eSpark-Backup/michaelquartey-sonography-hw/Design_Files/Renderings/3D_Top_View.PNG

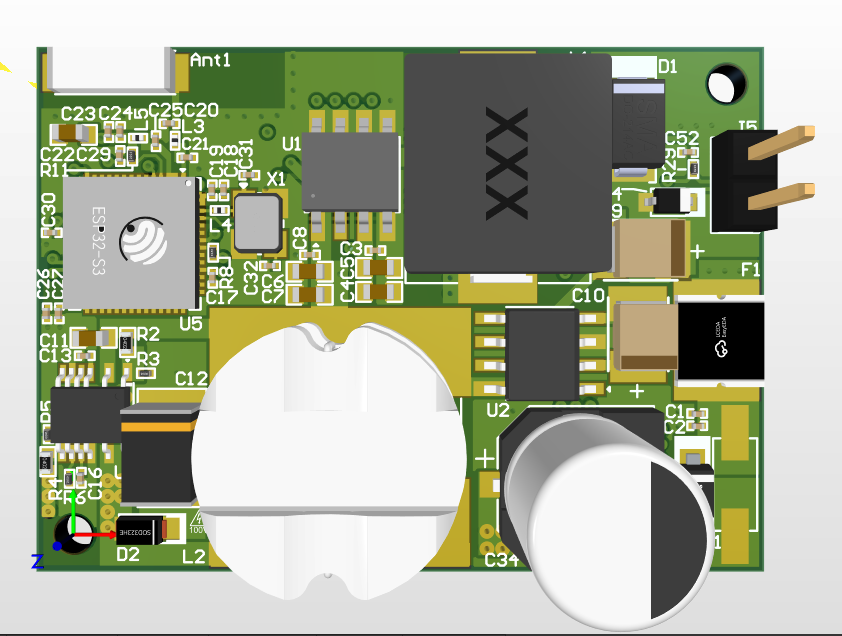
Design_Files/Renderings/3D_Top_View.PNG
