eSpark-Backup/michaelquartey-sonography-hw/Design_Files/Renderings/2D_BottomLayer.PNG

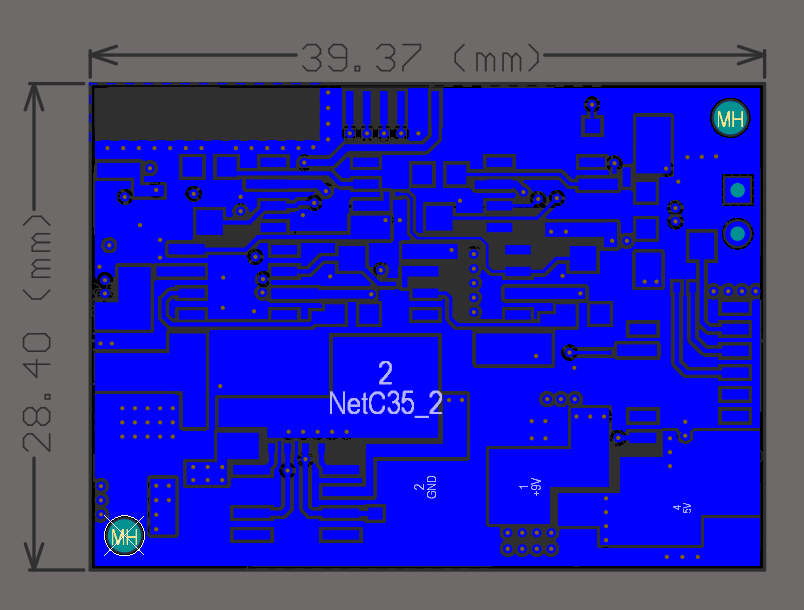
Design_Files/Renderings/2D_BottomLayer.PNG
