eSpark-Backup/michaelquartey-sonography-hw/Design_Files/Renderings/2D_C_View.PNG

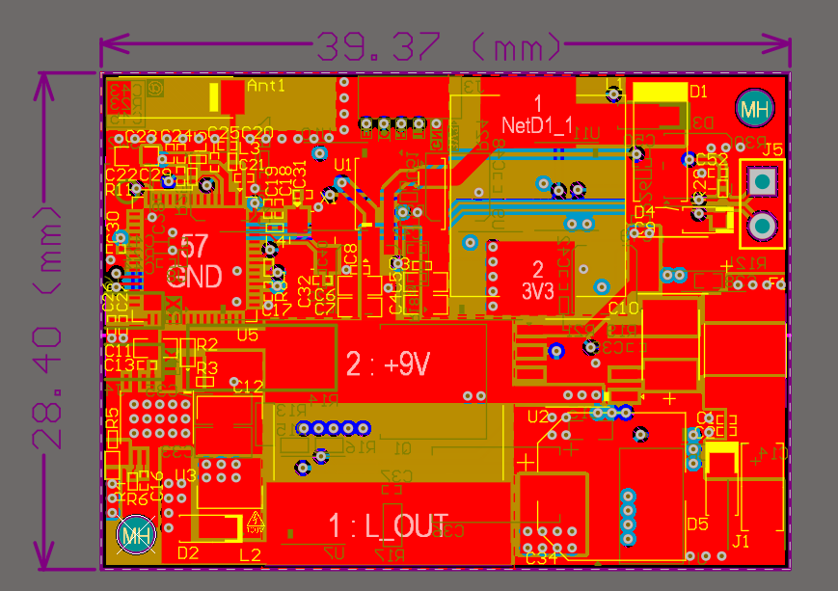
Design_Files/Renderings/2D_C_View.PNG
