eSpark-Backup/michaelquartey-sonography-hw/Design_Files/Renderings/2D_GND_Layer.PNG

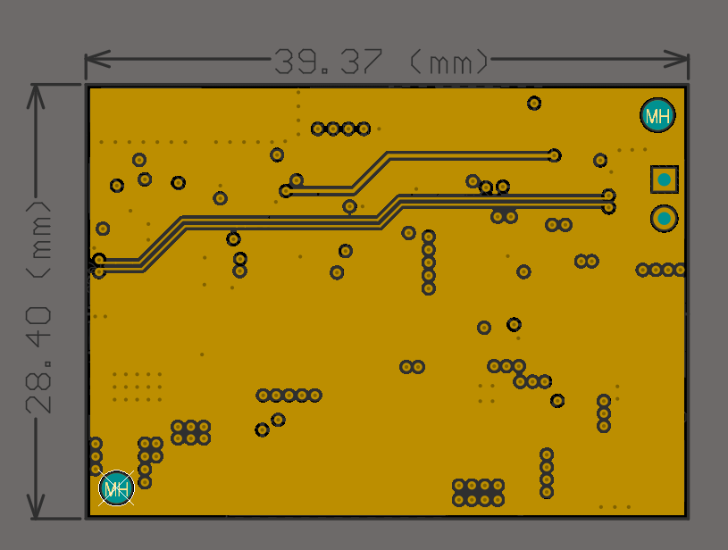
Design_Files/Renderings/2D_GND_Layer.PNG
