eSpark-Backup/michaelquartey-sonography-hw/Design_Files/Renderings/2D_PWR_Layer.PNG

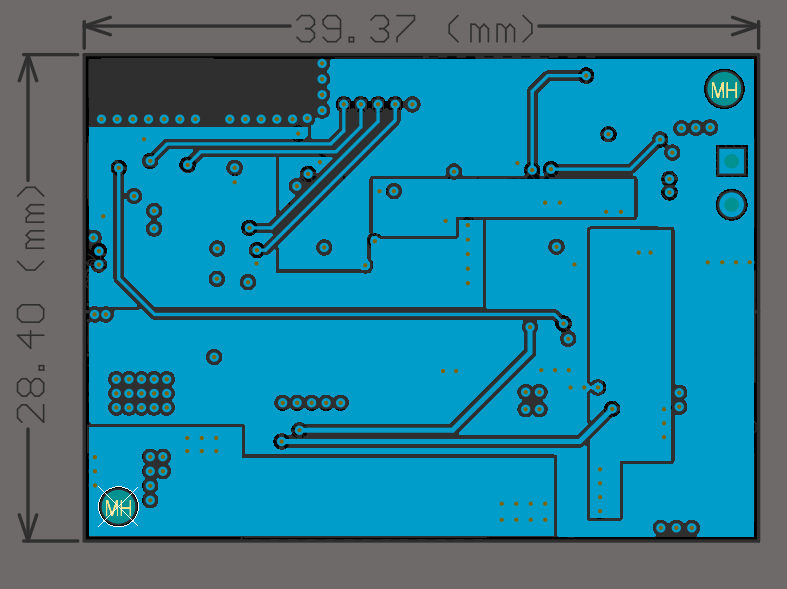
Design_Files/Renderings/2D_PWR_Layer.PNG
