eSpark-Backup/michaelquartey-sonography-hw/Design_Files/Renderings/2D_TopLayer.PNG

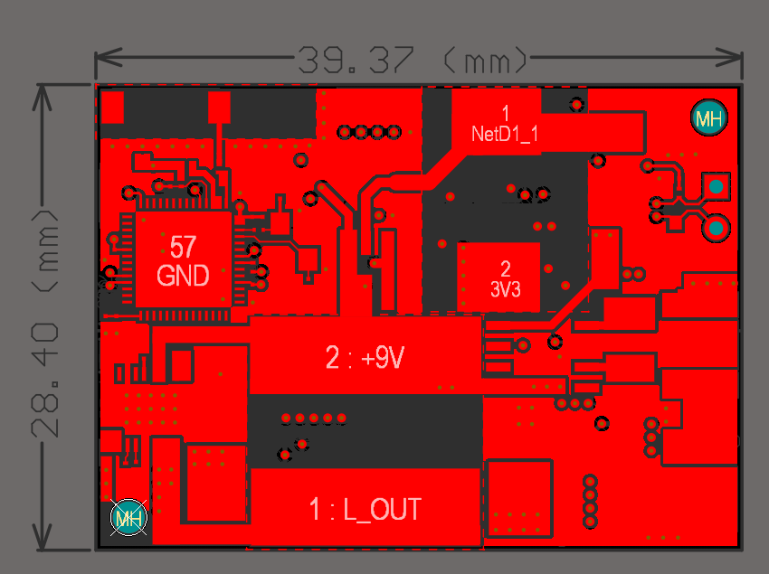
Design_Files/Renderings/2D_TopLayer.PNG
