eSpark-Backup/michaelquartey-sonography-hw/Design_Files/BOM/Clinet_BOM-Sonography-v1.0.xlsx

# | Item Type | Designator | Description | Footprint | Manufacturer Part Number | Manufacturer | Comment | Quantity | Remarks
1 | Antenna | ANT1 | SMD Antennas ROHS | AN6520-245 | AN6520-245 | Rainsun microwave Tech | AN6520-245 | 1
2 | Capacitor | C1, C13, C18, C23, C27, C29 | CAP CER 1UF 16V X5R 0201 | CAP-0201 | GRM033R61C105ME15D | Murata | 1uF | 6
3 | Capacitor | C2, C3, C8, C16, C17, C19, C24, C25, C26, C28, C30, C37, C40, C41, C42, C43, C46, C47, C48, C49 | CAP CER 0.1UF 25V X5R 0201 | CAP-0201 | GRM033R61E104KE14D | Murata | 0.1uF | 20
4 | Capacitor | C4, C5, C6, C7, C11, C15, C22 | 10uF 35V X5R 20% Pad SMD 0603 | Cap-0603 | GRM188R6YA106MA73D | Murata | 10uF | 7
5 | Capacitor | C9, C10, C14 | 10uF 25V 2.5Ω@100kHz ±10% CASE-B-3528 Tantalum Capacitors ROHS | Case-B | CA45-B025K106T | Xiangyee in S&T | 10uF | 3
6 | Capacitor | C12 | 250V 1uF X7R ±10% 1812 Multilayer Ceramic Capacitors MLCC - SMD/SMT ROHS | Cap-1812 | FS43X105K251EGG | PSA | 1uF | 1
7 | Capacitor | C20 | CAP CER 2.7PF 50V C0G/NPO 0201 | CAP-0201 | CC0201CRNPO9BN2R7 | Yageo | 2.7pF | 1
8 | Capacitor | C21 | CAP CER 4.7PF 50V C0G/NPO 0201 | CAP-0201 | CC0201BRNPO9BN4R7 | Yageo | 4.7pF | 1
9 | Capacitor | C31, C32 | CAP CER 22PF 50V C0G/NP0 0201 | CAP-0201 | GRM0335C1H220JA01D | Murata | 22pF | 2
10 | Capacitor | C33, C35 | 200V 100nF X7R ±10% 0805 Multilayer Ceramic Capacitors MLCC - SMD/SMT ROHS | Cap-0805 | FM21X104K201ECG | PSA | 100nF | 2
11 | Electrolytic Capacitor | C34 | 22uF 200V 320mA@100kHz ±20% SMD,D8xL16.5mm Aluminum Electrolytic Capacitors - SMD ROHS | VKMD1652D220MV | VKMD1652D220MV | Ymin | 22uF | 1
12 | Capacitor | C36 | 47uF 25V 0.9Ω@100kHz ±10% CASE-D-7343 Tantalum Capacitors ROHS | Case-D | CA45-D025K476T | Hunan Xiangyee in S&T | 47uF | 1
13 | Capacitor | C38 | 50V 50pF C0G ±5% 0402 Multilayer Ceramic Capacitors MLCC - SMD/SMT ROHS | Cap-0402 | 0402CG500J500NT | FH | 50pF | 1
14 | Capacitor | C39, C44, C45, C50, C51, C52 | 50V 1nF X7R ±10% 0201 Multilayer Ceramic Capacitors MLCC - SMD/SMT ROHS | CAP-0201 | 0201B102K500NT | FH | 1nF | 6
15 | Diode | D1 | 40V 3A 550mV@3A SMA(DO-214AC) Schottky Barrier Diodes (SBD) ROHS | SMA(DO-214AC) | B340A | FUXINSEMI | B340A | 1
16 | Schottky Barrier Diodes | D2 | Diode Schottky 150V 500mA 2-Pin SOD-323HE Emboss T/R | SOD-323HE | RB558VAM150TR | Rohm | RB558VAM150TR | 1
17 | Diode | D3 | 100V 400mW Single 1.25V@150mA 8ns 300mA SOD-123 Switching Diode ROHS | SOD-123 | 1N4148W | JSMSEMI | 1N4148W | 1
18 | Diode | D4 | ±5% Single 3.1V~3.5V 300mW 3.3V SOD-323 Zener Diodes ROHS | SOD-323 | MM3Z3V3 | JSMSEMI | MM3Z3V3 | 1
19 | Diode | D5 | 10.1A 200W 19.9V 13.3V 12V SOD-123F Electrostatic and Surge Protection (TVS/ESD) ROHS | SOD-123F | SMF12A | Shandong Jingdao Microelectronics | SMF12A | 1
20 | Fuse | F1 | 10V 2A 100A 4A 2018 Resettable Fuses ROHS | SMD2018-200 | SMD2018-200 | Tech Fuse | SMD2018-200 | 1
21 | Connector | J1 | Gold 250V 3A Brick nogging Square Pins 2.5mm 2P 260℃ 6mm -40℃~+105℃ 2.54mm 双排 Black Brass 2x1P SMD,P=2.54mm Pin Headers ROHS | X6521WVS-2x01H-C60D74 | X6521WVS-2x01H-C60D74 | XKB Connectivity | X6521WVS-2x01H-C60D74 | 1
22 |  | J3 | 1x6P | 1x6p |  |  | 1x6P | 1
23 | SMD Pad | J4, J6 | Wire Connecting Pad | 1P SMD PAD | 1P SMD PAD |  | 1P SMD PAD | 2
24 | Male Header | J5 | CONN HEADER VERT 2POS 2.54MM | HDR1X2_ | 8266292 | TE Connectivity | 826629-2 | 1
25 | Inductor | L1 | 3A 47uH Molding Choke ±20% 4.5A SMD Power Inductors ROHS | SMMS1050-470M | SMMS1050-470M | SXN | 47uH | 1
26 | Inductor | L2 | Ind Power Unshielded Wirewound 100uH 10% 100KHz 25Q-Factor Ferrite 1.9A T/R | SDR1307A-101K | SDR1307A-101K | Bourns | 100uH | 1
27 | Inductor | L3 | FIXED IND 1.6NH 1A 50 MOHM SMD | IND-0201 | LQP03HQ1N6B02D | Murata | 1.6nH | 1
28 | Inductor | L4 | 140mA 24nH ±3% 2.3Ω 0201 Inductors (SMD) ROHS | IND-0201 | LQP03TN24NH02D | Murata | 24nH | 1
29 | Inductor | L5 | FIXED IND 2NH 600MA 100 MOHM SMD | IND-0201 | MLG0603P2N0CT000 | TDK | 2nH | 1
30 | Mosfet | Q1 | 200V 5A 78W 580mΩ@10V,2.5A 3V@250uA N Channel TO-252-2(DPAK) MOSFETs ROHS | DPAK | 5N20A-252 | GOFRD | 5N20A-252 | 1
31 | Resistor | R2, R4 | 125mW ±100ppm/℃ ±0.5% 1MΩ 0402 Chip Resistor - Surface Mount ROHS | Res-0402 | WF04H1004DTL |  | 1M | 2
32 | Resistor | R3 | SMD Chip Resistor, 287 kOhm, ± 1%, 50 mW, 0201 [0603 Metric], Thick Film, General Purpose | Res-0201 | RC0201FR-07287KL | YAGEO | 287K | 1
33 | Resistor | R5 | 50mW Thick Film Resistors 25V ±1% ±200ppm/℃ 16.2kΩ 0201 Chip Resistor - Surface Mount ROHS | Res-0201 | RTT011622FTH | RALEC | 16.2K | 1
34 | Resistor | R6 | Res Thick Film 0201 154K Ohm 1% 1/20W ±200ppm/°C Molded SMD Paper T/R | Res-0201 | RC0201FR-07154KL | YAGEO | 154K | 1
35 | Resistor | R8 | RES 499 OHM 1% 1/20W 0201 | Res-0201 | RC0201FR-07499RL | Yageo | 499R | 1
36 | Resistor | R11 | RES SMD 10K OHM 1% 1/20W 0201 | Res-0201 | RC0201FR-0710KL | Yageo | 10K | 1
37 | Potentiometer | R12, R18, R19, R25, R30 | TRIMMER 10K OHM 0.1W J LEAD TOP | TC33X-2-103E_ | TC33X-2-103E | Bourns | 10K | 5
38 | Resistor | R13 | RES SMD 3K OHM 1% 1/3W 0603 | Res-0603 | CRCW06033K00FKEAHP | Vishay Intertech | 3K | 1
39 | Resistor | R14 | 1W Thick Film Resistors 200V ±100ppm/℃ ±5% 51Ω 2512 Chip Resistor - Surface Mount ROHS | RES-2512 | RC2512JK-0751RL | YAGEO | 51R | 1
40 | Resistor | R15, R16 | RESISTOR 0402 JUMPER ZERO OHM | Res-0402 | AC0402FR-070RL | Yageo | 0R | 2
41 | Resistor | R17 | RES SMD 10K OHM 5% 1/4W 0603 | Res-0603 | ESR03EZPJ103 | ROHM Semicon | 10K | 1
42 | Resistor | R20 | 50mW Thick Film Resistors ±5% ±200ppm/℃ 68Ω 0201 Chip Resistor - Surface Mount ROHS | Res-0201 | 0201WMJ0680TEE | UNI-ROYAL | 68R | 1
43 | Resistor | R21 | 50mW Thick Film Resistors ±200ppm/℃ ±5% 820Ω 0201 Chip Resistor - Surface Mount ROHS | Res-0201 | WR02X821JAL | Walsin Tech Corp | 820R | 1
44 | Resistor | R22, R26 | 50mW ±1% ±200ppm/℃ 330Ω 0201 Chip Resistor - Surface Mount ROHS | Res-0201 | RC-01W3300FT | FH | 330R | 2
45 | Resistor | R23 | 50mW ±5% ±200ppm/℃ 470Ω 0201 Chip Resistor - Surface Mount ROHS | Res-0201 | RC-01W471JT | FH | 470R | 1
46 | Potentiometer | R24 | TRIMMER 100K OHM 0.1W J LEAD TOP | TC33X-2-104E_ | TC33X-2-104E | Bourns | 100K | 1
47 | Resistor | R27 | 50mW Thick Film Resistors ±5% ±200ppm/℃ 1.5kΩ 0201 Chip Resistor - Surface Mount ROHS | Res-0201 | RTT01152JTH | RALEC | 1.5K | 1
48 | Resistor | R28 | RES 1K OHM 1% 1/20W 0201 | Res-0201 | RC0201FR-071KL | Yageo | 1K | 1
49 | Resistor | R29 | 50mW ±1% 100Ω 0201 Chip Resistor - Surface Mount ROHS | Res-0201 | CR0201FH1000G | LIZ ELEC | 100R | 1
50 | Switch | SW2 | SWITCH TACTILE SPST-NO 0.05A 12V | B3U-1000P | B3U-1000P | Omron | B3U-1000P | 1
51 | Regulator | U1 | IC REG BUCK 3.3V 2A 8SOIC | SOP-8L | AP1509-33SG-13 | Diodes | AP1509-33SG-13 | 1
52 | IC | U2 | Charge Pump INV/STPUP/STPDN -1.5V to -10V 100mA 8-Pin SOIC T/R / IC REG SWITCHD CAP INV 8SOIC | SOIC-8(0.154", 3.90mm Width) | TL7660CDR | Texas Instruments | TL7660CDR | 1
53 | IC | U3 | IC REG MULTI CONFG ADJ 16MSOP | 16-MSOP-EP | LT8331IMSE#TRPBF | Analog Devices | LT8331IMSE#TRPBF | 1
54 | IC | U4 | SOT-223 Linear Voltage Regulators (LDO) ROHS | SOT- 223 | AMS1117-5.0 | HX(hengjiaxing) | AMS1117-5.0 | 1
55 | IC | U5 | 21dBm ESP32-S3R8 2.4GHz SMD WiFi Modules ROHS | QFNWB-56 (7×7) | ESP32-S3FH4R2 | Espressif Systems | ESP32-S3FH4R2 | 1
56 | IC | U6 | 45ns 4.75V~5.25V SOIC-14 Monostable Multivibrators ROHS | SOIC-14 | SN74121D | Taxes Instrument | SN74121D | 1
57 | IC | U7 | MOSFET 4.5V~15V SOIC-8 Gate Drive ICs ROHS | SOIC-8(0.150", 3.80mm Width) | ICL7667CBAZA | RENESAS | ICL7667CBAZA | 1
58 | IC | U8, U9, U10 | Video Amplifier, 1, 140 Mhz, 2500 V/ S, 0 C, 70 C, 100 Ma Rohs Compliant: Yes | SOIC-8(0.154", 3.90mm Width) | AD811JRZ | Analog Devices | AD811JRZ | 3
59 | IC | U11 | Very High Speed, High Output Current, Voltage Feedback Amplifier 8-SOIC -40 to 85 | SOIC-8(0.154", 3.90mm Width) | LM7171AIMX/NOPB | TI National Semiconductor | LM7171AIMX/NOPB | 1
60 | Crystal | X1 | 40MHz SMD Crystal Resonator 15pF SMD3225-4P Crystals ROHS | X322540MPB4SI_ | X322540MPB4SI | Yangxing Tech | 40MHz | 1
