eSpark-Backup/michaelquartey-sonography-hw/Design_Files/Supporting_Files/PCB_Sonography-v1.0.DXF

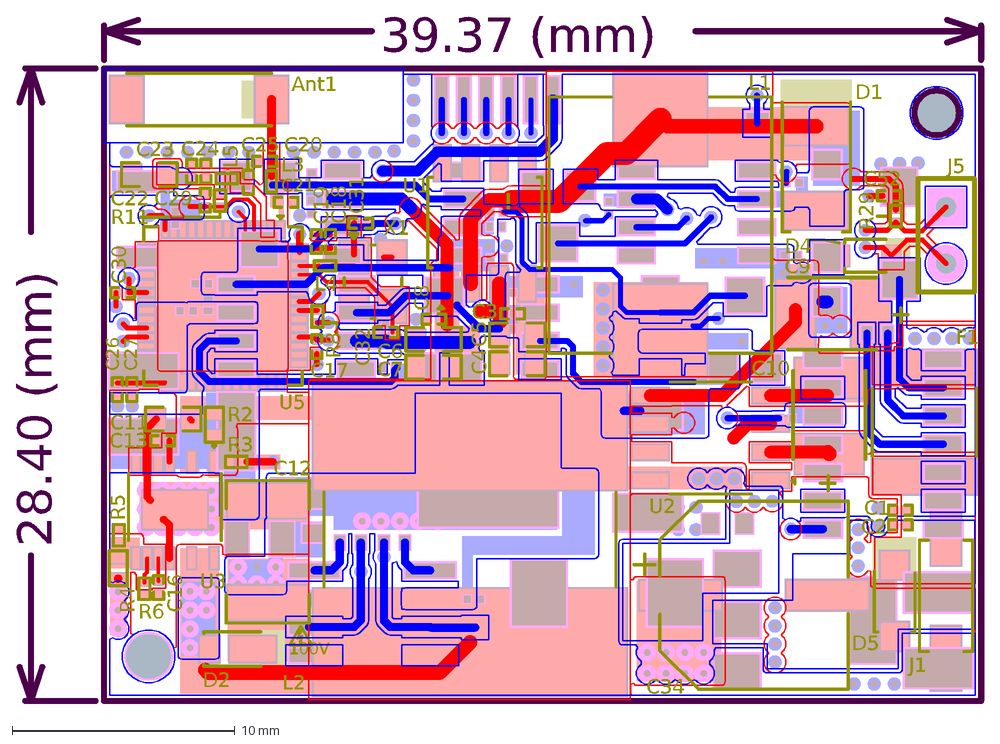
[picture p9: CAD file, 2024-06-08]
Design_Files/Supporting_Files/PCB_Sonography-v1.0.DXF
100V
28.40 (mm)
39.37 (mm)
Ant1
U5
D5
R5
C10
C9
L3
D4
D2
U3
C34
F1
J1
J5
X1
R11
R8
L5
L4
C27
C25
C24
C23
C22
C13
C8
C3
U1
U2
R29
R6
R4
R3
R2
L2
L1
D1
C52
C32
C31
C30
C29
C26
C21
C20
C19
C18
C17
C16
C12
C11
C7
C6
C5
C4
C2
C1
