eSpark-Backup/michaelquartey-sonography-hw/(list of files, cad)

Other CAD files:
Design_Files/Supporting_Files/PCB_Sonography-v1.0.DWG
