eSpark-Backup/michaelquartey-sonography-hw/Design_Files/Schematics/Schematics_Sonography-v1.0.pdf

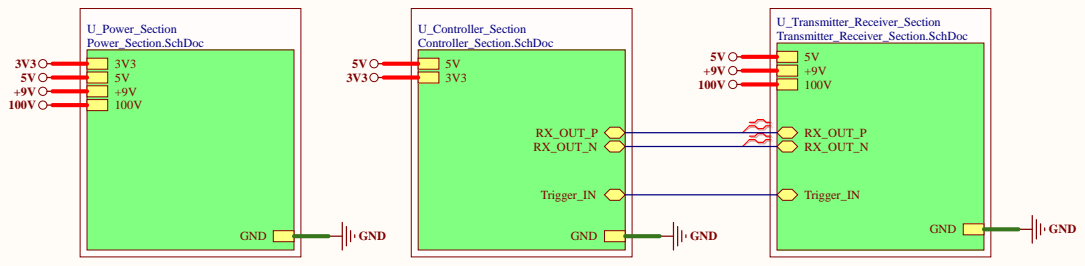
[picture p10: page 1]

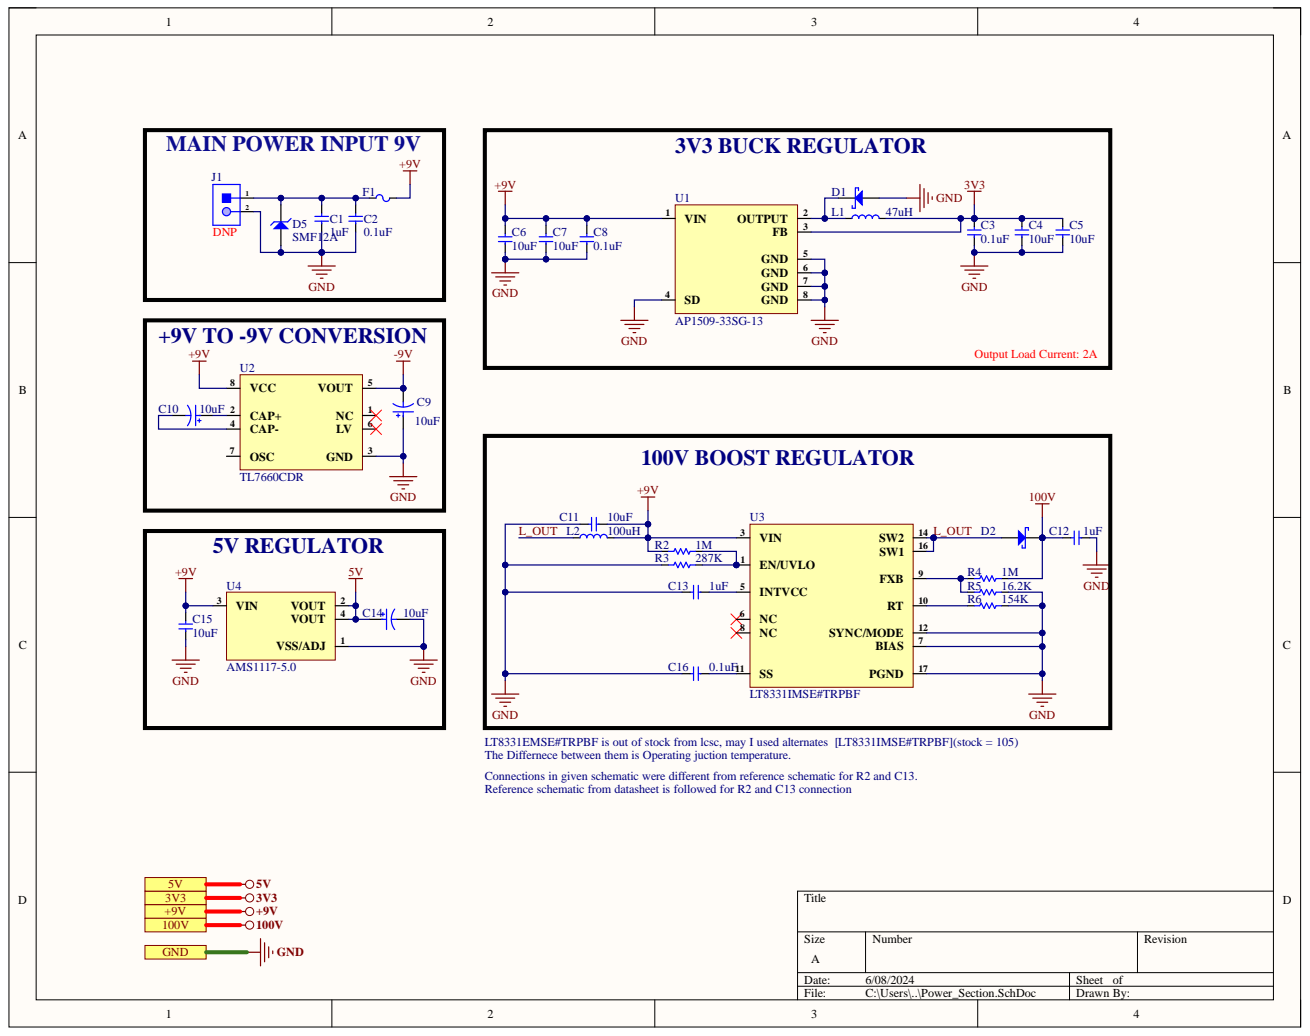
[picture p11: page 2]

LT8331EMSE#TRPBF is out of stock from lcsc, may I used alternates [LT8331IMSE#TRPBF](stock = 105)
The Differnece between them is Operating juction temperature.
Connections in given schematic were different from reference schematic for R2 and C13.
Reference schematic from datasheet is followed for R2 and C13 connection

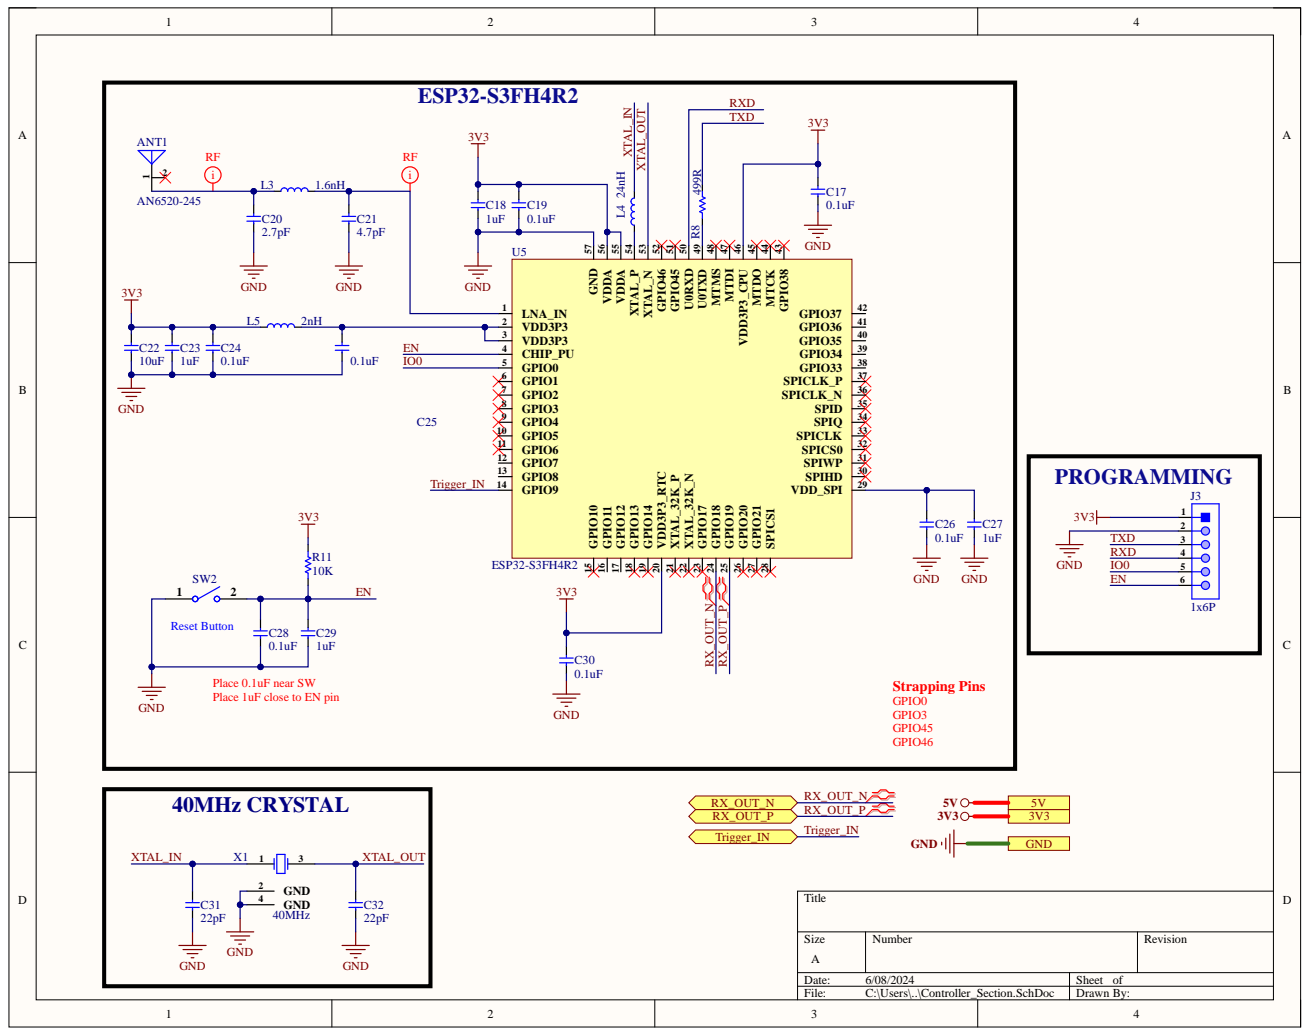
[picture p12: page 3]

Place 0.1uF near SW
Place 1uF close to EN pin

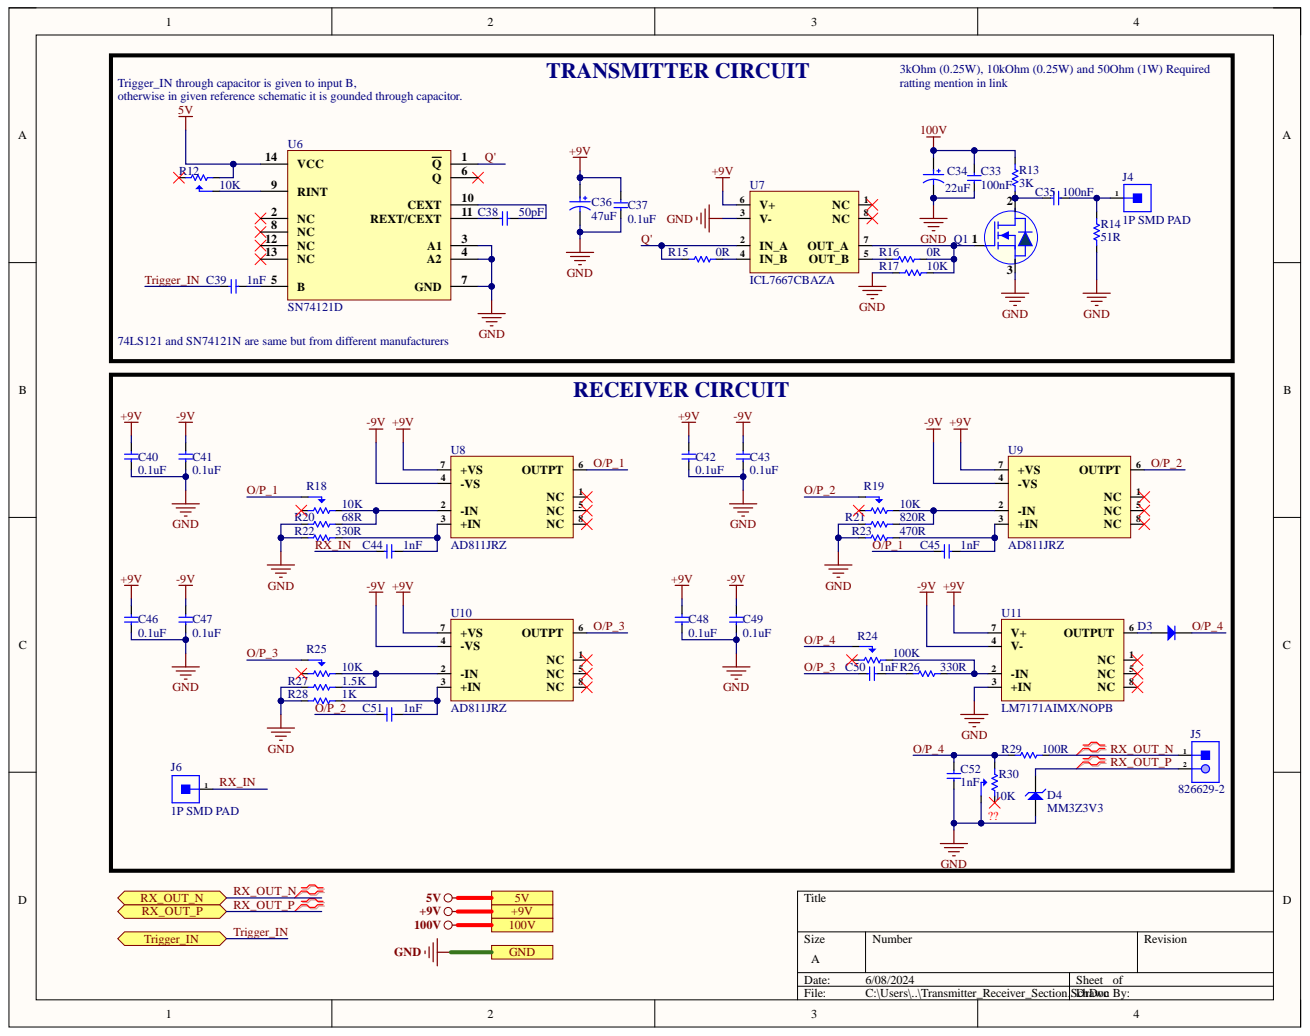
[picture p13: page 4]

3kOhm (0.25W), 10kOhm (0.25W) and 50Ohm (1W) Required
ratting mention in link

Trigger_IN through capacitor is given to input B,
otherwise in given reference schematic it is gounded through capacitor.

74LS121 and SN74121N are same but from different manufacturers
