eSpark-Backup/michaelquartey-sonography-hw/Design_Files/Schematics/Assembly_Drawings-v1.0.pdf

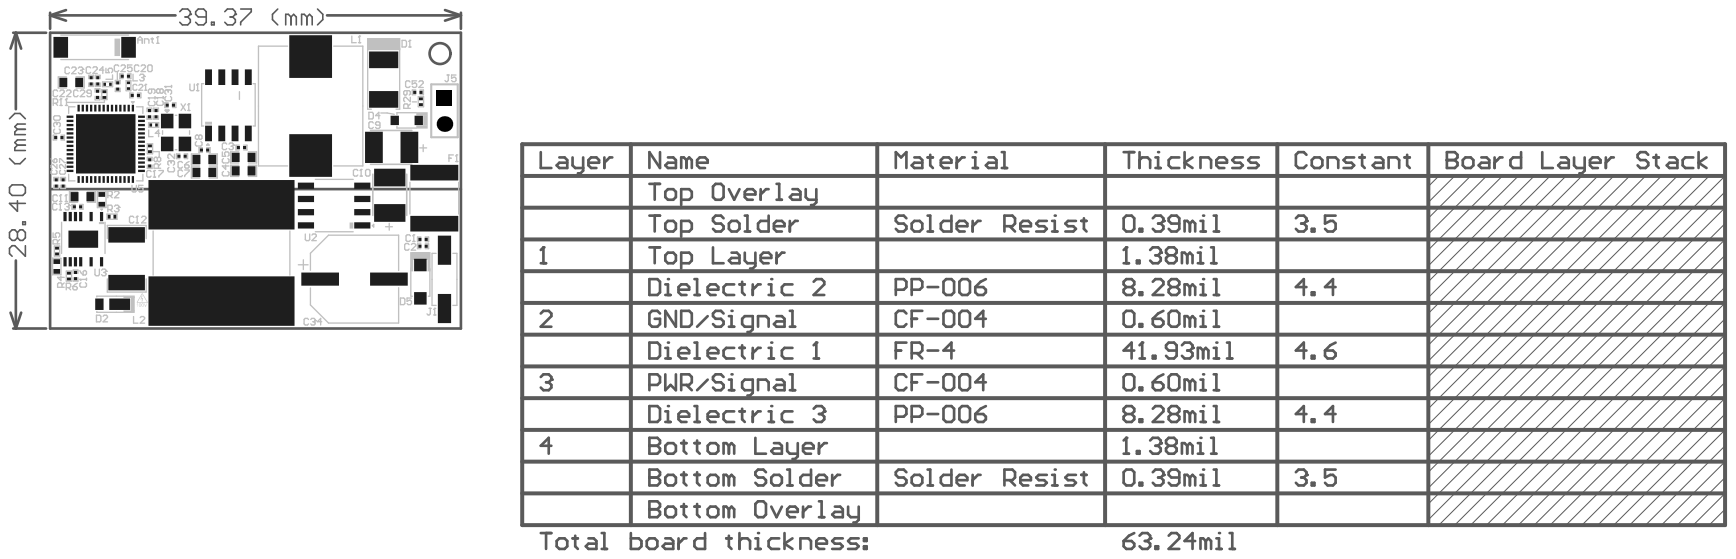
[picture p14: page 1]

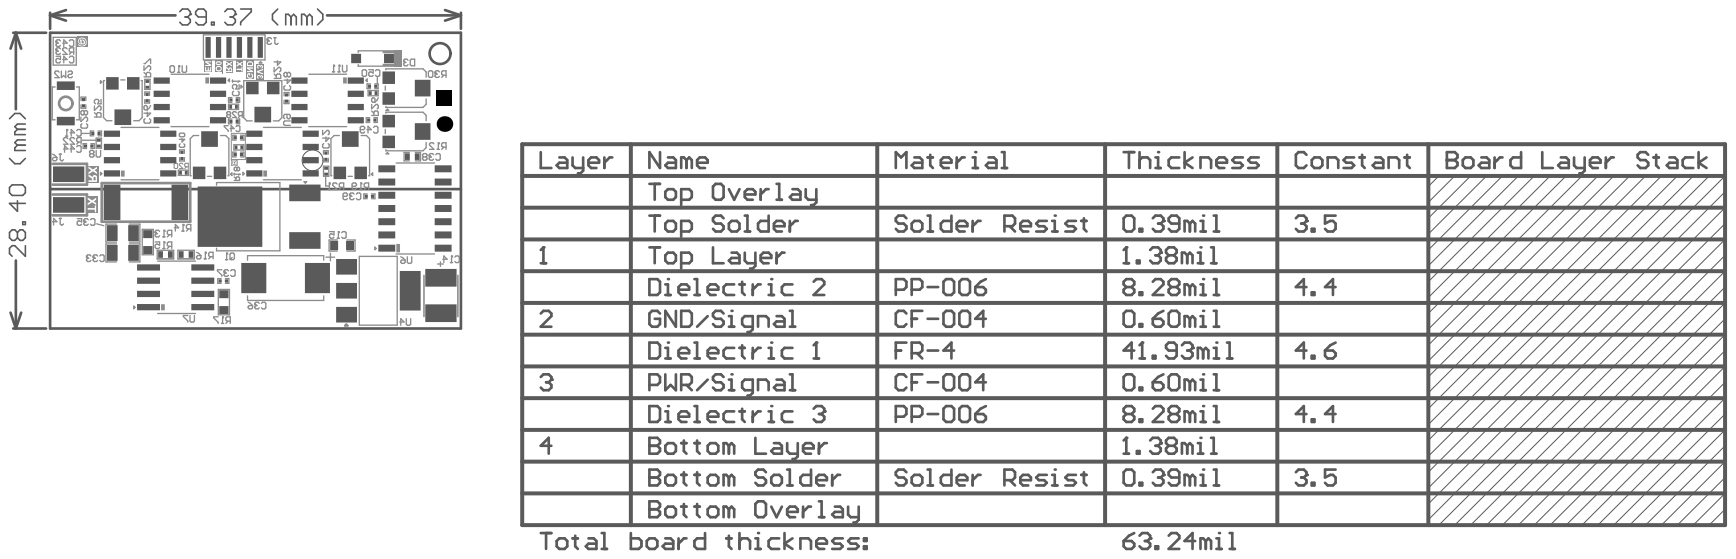
[picture p15: page 2]
