eSpark-Backup/michaelquartey-sonography-hw/(list of files, drawings)

Other design files:
Design_Files/Controller_Section.SchDoc
Design_Files/PCB_Sonography-v1.0.PcbDoc
Design_Files/Power_Section.SchDoc
Design_Files/Sonography-v1.0.PrjPcb
Design_Files/Top_sheet.SchDoc
Design_Files/Transmitter_Receiver_Section.SchDoc
