eSpark-Backup/michaelquartey-sonography-hw/(commit log)

2023-11-24 Receiver circuitry added
    [Receiver_Section.SchDoc, Sonography_Project.PrjPcb]
2023-11-27 #2 Schematic in Progress
    [Controller_Section.SchDoc, Power_Section.SchDoc, Receiver_Section.SchDoc, Sonography_Project.PrjPcb]
2023-11-29 #2 In progress
    [Controller_Section.SchDoc, Power_Section.SchDoc, Receiver_Section.SchDoc, Sonography_Project.PrjPcb, Transmitter_Section.SchDoc]
2023-12-04 Top sheet in Progress
    [Controller_Section.SchDoc, Power_Section.SchDoc, Sonography_Project.PrjPcb, Top_sheet.SchDoc, Transmitter_Receiver_Section.SchDoc]
2023-12-05 #2 Schematic completed
    [Controller_Section.SchDoc, Power_Section.SchDoc, Sonography_Project.PrjPcb, Top_sheet.SchDoc, Transmitter_Receiver_Section.SchDoc]
2023-12-05 Parts Placement in Progress
    [Controller_Section.SchDoc, Power_Section.SchDoc, Sonography_PCB.PcbDoc, Sonography_Project.PrjPcb, Transmitter_Receiver_Section.SchDoc]
2023-12-05 #3 Placement In-progress.
    [Controller_Section.SchDoc, Power_Section.SchDoc, Sonography_PCB.PcbDoc, Sonography_Project.PrjPcb, Top_sheet.SchDoc, Transmitter_Receiver_Section.SchDoc]
2023-12-06 #3 Parts Placement in progress
    [Controller_Section.SchDoc, Power_Section.SchDoc, Sonography_PCB.PcbDoc, Sonography_Project.PrjPcb, Transmitter_Receiver_Section.SchDoc]
2023-12-11 #3 Parts Placement completed
    [Power_Section.SchDoc, Sonography_PCB.PcbDoc, Sonography_Project.PrjPcb, Transmitter_Receiver_Section.SchDoc]
2023-12-12 #3 Routing in Progress
    [Controller_Section.SchDoc, Power_Section.SchDoc, Sonography_PCB.PcbDoc, Transmitter_Receiver_Section.SchDoc]
2023-12-15 #3 Routing completed
    [Sonography_PCB.PcbDoc]
2023-12-18 #3 modification in Routing
    [Power_Section.SchDoc, Sonography_PCB.PcbDoc]
2023-12-19 LT8331IMSE#TRPBF footprint updated in PCB
    [Power_Section.SchDoc, Sonography_PCB.PcbDoc, Transmitter_Receiver_Section.SchDoc]
2023-12-20 #3 PCB updated acc to library review
    [Controller_Section.SchDoc, Power_Section.SchDoc, Sonography_PCB.PcbDoc, Transmitter_Receiver_Section.SchDoc]
2023-12-20 Parameters added for BOM easiness
    [Controller_Section.SchDoc, Power_Section.SchDoc, Sonography_PCB.PcbDoc, Sonography_Project.PrjPcb, Transmitter_Receiver_Section.SchDoc]
2024-01-22 #3 Placement in Progress
    [Controller_Section.SchDoc, Power_Section.SchDoc, Sonography_PCB.PcbDoc, Transmitter_Receiver_Section.SchDoc]
2024-01-24 #3 Routing Completed, no DRC errors
    [Controller_Section.SchDoc, Power_Section.SchDoc, Sonography_PCB.PcbDoc, Transmitter_Receiver_Section.SchDoc]
2024-01-25 #5 Adjustments in routing and designators: Review In-process.
    [Controller_Section.SchDoc, PCB_Sonography-v1.0.PcbDoc, Power_Section.SchDoc, Sonography-v1.0.PrjPcb, Sonography_PCB.PcbDoc, Sonography_Project.PrjPcb, Top_sheet.SchDoc, Transmitter_Receiver_Section.SchDoc]
2024-01-26 #3 Changes done acc: to #4 and Client BOM generated But peripherals need to be added
    [Client_BOM.xlsx, Controller_Section.SchDoc, PCB_Sonography-v1.0.PcbDoc, Power_Section.SchDoc, Sonography-v1.0.PrjPcb]
2024-01-26 #5 Fresh Deliverables generated: Peripherals need to add in Client BOM
    [Centroid_File-Sonography-v1.0.csv, Controller_Section.SchDoc, PCB_Sonography-v1.0.DWG, PCB_Sonography-v1.0.DXF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]
2024-01-29 #5 Fresh Deliverables after modifications in Routing: Peripherals needs to be entered in BOM.
    [Centroid_File-PCB_Sonography-v1.0.csv, Centroid_File-Sonography-v1.0.csv, Client_BOM.xlsx, PCB_Sonography-v1.0.DWG, PCB_Sonography-v1.0.DXF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]
2024-04-01 added .gitignore
    [PCB_Sonography-v1.0.GBL, PCB_Sonography-v1.0.GBO, PCB_Sonography-v1.0.GBP, PCB_Sonography-v1.0.GBS, PCB_Sonography-v1.0.GTL, PCB_Sonography-v1.0.GTO, PCB_Sonography-v1.0.GTP, PCB_Sonography-v1.0.GTS]
2024-05-21 #2 PCB updated acc to required change in sch
    [Controller_Section.SchDoc, PCB_Sonography-v1.0.PcbDoc, Sonography-v1.0.PrjPcb]
2024-05-24 #2 LCD and its circuitry removed
    [Controller_Section.SchDoc, PCB_Sonography-v1.0.PcbDoc]
2024-05-31 #3 Placement completed
    [PCB_Sonography-v1.0.PcbDoc]
2024-06-06 PCB completed, step file added, programing connector added in controller sheet
    [Controller_Section.SchDoc, PCB_Sonography-v1.0.PcbDoc]
2024-06-07 #5 In-progress.
    [Controller_Section.SchDoc, PCB_Sonography-v1.0.PcbDoc, Power_Section.SchDoc, Sonography-v1.0.PrjPcb, Transmitter_Receiver_Section.SchDoc]
2024-06-08 #5 Done: Fresh Deliverables created along with fresh Client BOM.
    [Centroid_File-PCB_Sonography-v1.0.csv, Clinet_BOM-Sonography-v1.0.xlsx, PCB_Sonography-v1.0.DWG, PCB_Sonography-v1.0.DXF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]
